trupples/colorimeter-board/README.md

# ARCHIVED, NOT THE LATEST REVISION OF THE M2K COLORIMETER BOARD

This repo contains the first revision of the board. It has since been moved to [analogdevicesinc/education_tools](https://github.com/analogdevicesinc/education_tools).

# Two channel colorimeter

Folders:
- `board-main/` - KiCad project of main PCB
- `board-led/` - KiCad project of RGB LED riser board
- `board-photodiode/` - KiCad project of photodiode riser board
- `symbols/` - common KiCad symbol libraries
- `footprints/` - common KiCad footprint libraries + 3D models

## Main PCB

## Riser boards

Both riser boards position the optical center of their respective devices at 19.05mm above the "bottom" edge of the pin socket connector:

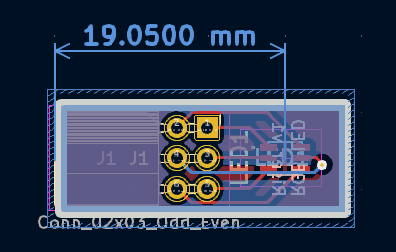
[picture p1: docs/led-riser.png]
LED riser PCB showing 19.05mm dimension


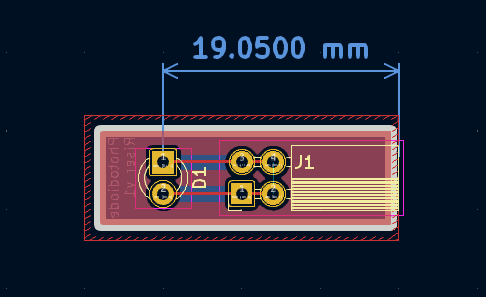
[picture p2: docs/pd-riser.png]
Photodiode riser PCB showing 19.05mm dimension


## TODO

- [ ] Choose one of the many available methods for driving the LEDs
- [ ] Prepare 3D model for 3D printed holder
- [ ] Test manufacturing run!
