trupples/colorimeter-board/footprints/ASMB-UTF0-0D20B.stp

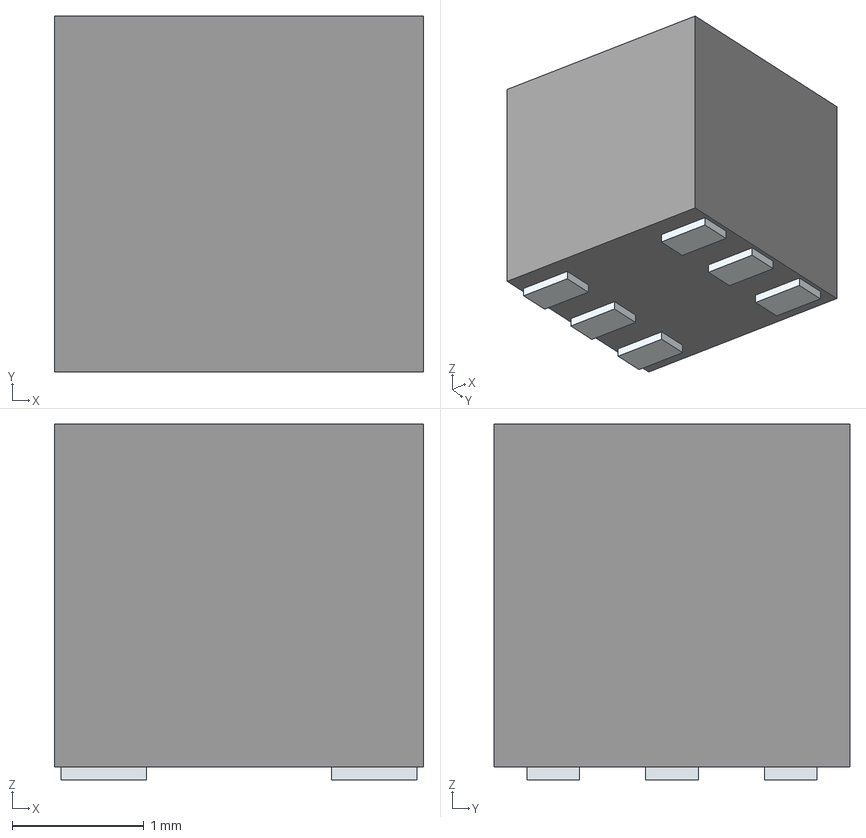
[picture p3: CAD file, 2023-09-25]
footprints/ASMB-UTF0-0D20B.stp
2.80 x 2.70 x 2.70 mm
Pins
