trupples/colorimeter-board/footprints/521-8559F.stp

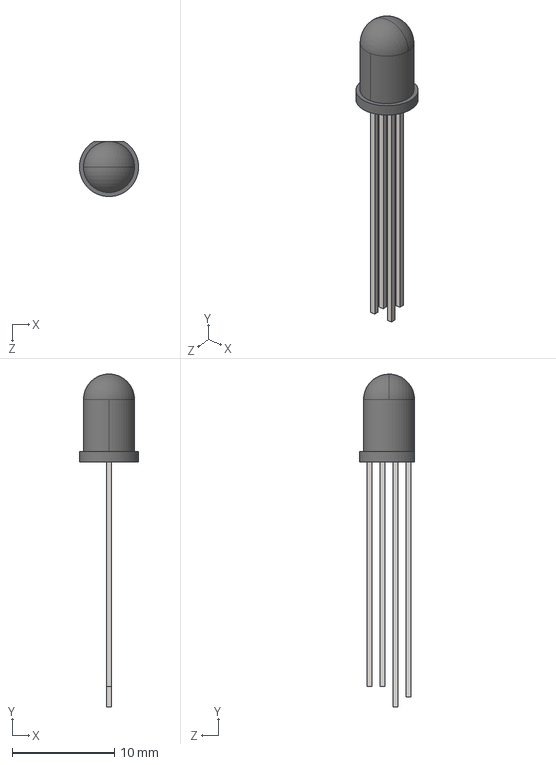
[picture p4: CAD file, 2023-10-06]
footprints/521-8559F.stp
5.79 x 32.6 x 5.40 mm
