trupples/colorimeter-board/footprints/MAX4619CPE+.stp

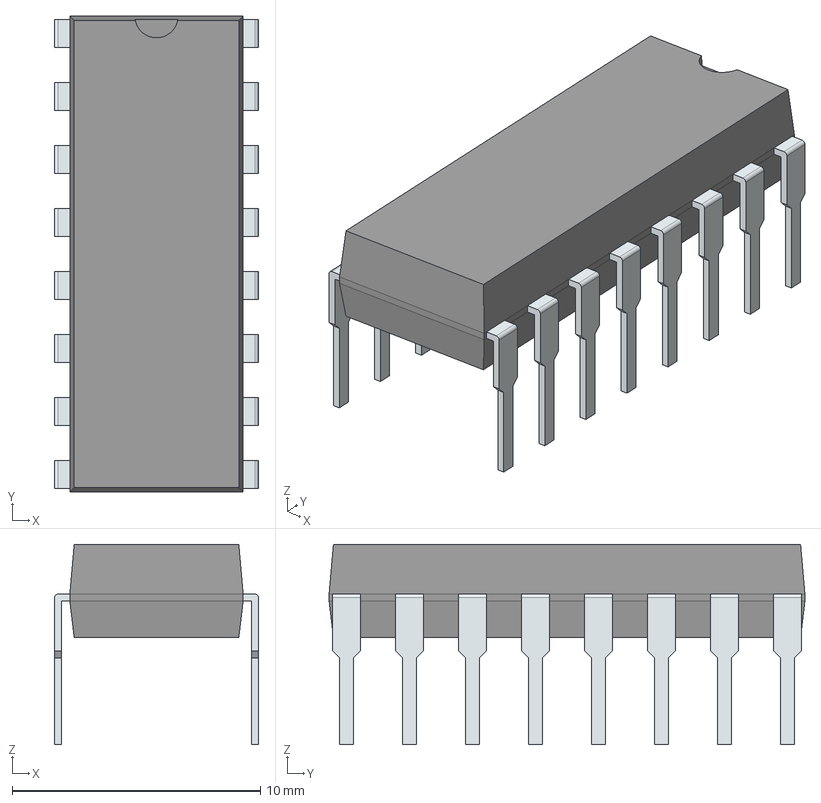
[picture p5: CAD file, 2023-10-06]
footprints/MAX4619CPE+.stp
8.22 x 19.2 x 8.07 mm
PinsArrayLR
