trupples/colorimeter-board/(threads)

Thread 1 (2023-12-19):

Update suggestions

mthoren-adi, 2023-12-19:
Notes from first build / run:

1.  DEFINITELY update the 2x3 LED/PD header footprints with larger holes. Same as the JPx headers would work fine.
2. U1 and U2 - see if you can find a footprint with elongated pads. Also U2 holes are fairly small.
3. All routed traces can be 0.5 mm, with the possible exception of the J1-J2 connections. The wider power traces can stay as-is.
4. Let's take out the 10k TIA resistor option, and add separate compensation capacitors for the 100k and 1M options. The cap should be right in parallel with the resistor such that the jumper selects both.
5. The LED and PD risers are almost perfect and work fine - but they sit off the board by the thickness of the mating header's plastic retainer. The LED/PD doesn't have to be perfectly centered vertically with respect to the beamsplitter, but wouldn't hurt to scoot it down a bit. Also if it touches the main board, then a bead of glue or epoxy could be applied, without gumming up the connector itself if it ever had to be extracted.
6. Add semicircular notches where the m2k box touches the board, to allow full insertion of the connector. It worked fine, but a few extra mm of insertion wouldn't hurt.
