trupples/colorimeter-board/(commit log)

2023-09-22 LED Boost converter half done and awful
    Can barely fit it on the PCB, it's total spaghetti. Saving this to branch out and use the analog switch method
    [colorimeter-2.kicad_pcb, colorimeter-2.kicad_sch]
2023-09-25 MAX4583 switch between LED groups + amp decoupling caps
    [colorimeter-2.kicad_pcb, colorimeter-2.kicad_sch]
2023-09-25 Tweaked decoupling caps and silkscreen
    [colorimeter-2.kicad_pcb]
2023-09-25 [monorepo] Move main board project to its own folder
    [colorimeter-2.kicad_pcb, colorimeter-2.kicad_sch]
2023-09-25 [monorepo] Bring in other board projects
    [ASMB-UTF0-0D20B.stp, colorimeter-led.kicad_pcb, colorimeter-led.kicad_sch, colorimeter-photodiode.kicad_pcb, colorimeter-photodiode.kicad_sch]
2023-09-25 [monorepo] Fix broken symbol and footprints after restructure
    [colorimeter-2.kicad_pcb, colorimeter-2.kicad_sch]
2023-09-25 Clean up local paths
    [colorimeter-2.kicad_pcb, colorimeter-photodiode.kicad_pcb]
2023-09-27 Add SMA connectors, enlarge board to fit them
    [colorimeter-2.kicad_pcb, colorimeter-2.kicad_sch]
2023-10-06 Add jumper for loopback on channel 2
    [colorimeter-2.kicad_pcb, colorimeter-2.kicad_sch]
2023-10-06 Space out SMA connectors and reroute
    [colorimeter-2.kicad_pcb]
2023-10-06 Add LED circuit + rough placement
    [MAX4619CPE+.stp, colorimeter-2.kicad_pcb, colorimeter-2.kicad_sch]
2023-10-06 Changed PD to 3x2 connector + PCB tweaks
    [colorimeter-2.kicad_pcb]
2023-10-06 Add bypass caps
    [colorimeter-2.kicad_pcb, colorimeter-2.kicad_sch]
2023-10-06 Change LED,PD to custom symbol
    [colorimeter-2.kicad_pcb, colorimeter-2.kicad_sch]
2023-10-06 Change PD, LED boards to match pinout on main board
    Added ground connections to both
    Changed Photodiode to have 3x2 connector
    Changed LED to common anode
    Added new symbol & footprint for common anode RGB LED
    [521-8559F.stp, colorimeter-led.kicad_pcb, colorimeter-led.kicad_sch, colorimeter-photodiode.kicad_pcb, colorimeter-photodiode.kicad_sch]
2023-10-06 Tweak main board
    Added teardrops (just me playing around)
    Enlarged it by a bit to not have traces running *right* next to the cut
    [colorimeter-2.kicad_pcb, colorimeter-2.kicad_sch]
2023-10-09 Tie NC pin of switch to V- for pin compatibility
    [colorimeter-2.kicad_pcb, colorimeter-2.kicad_sch]
2023-10-09 Tweak trace widths and schematic layout
    [colorimeter-2.kicad_pcb, colorimeter-2.kicad_sch]
2023-10-09 Start rev 3, many changes
    4 layer PCB, all THT components for easier assembly, slightly larger board
    [colorimeter-2.kicad_pcb, colorimeter-2.kicad_sch]
2023-10-10 Tweak routing
    [colorimeter-2.kicad_pcb]
2023-10-10 Add selection for LED reference/sink
    [colorimeter-2.kicad_pcb, colorimeter-2.kicad_sch]
2023-10-10 Tweak LEDSink routing
    [colorimeter-2.kicad_pcb, colorimeter-2.kicad_sch]
2023-10-10 Space out and tidy up LED power
    [colorimeter-2.kicad_pcb]
2023-10-10 Make power traces THICK (1mm), add net-ties to op-amp +
    [colorimeter-2.kicad_pcb, colorimeter-2.kicad_sch]
2023-10-11 Tweak LED power and decoupling caps
    [colorimeter-2.kicad_pcb, colorimeter-2.kicad_sch]
2023-10-11 Remove "Helloworld Devices", add "FiSl"
    [colorimeter-2.kicad_pcb]
2023-10-12 Fix bad switch connection
    Bsw and B1 were not connected to the correct pins of the switch IC
    [colorimeter-2.kicad_pcb, colorimeter-2.kicad_sch]
2023-10-12 Mark unused / general purpose pins
    [colorimeter-2.kicad_sch]
2023-10-12 Add comments and tidy up schematic
    [colorimeter-2.kicad_sch]
2023-10-12 Add m2k header pinout silkscreen
    [colorimeter-2.kicad_pcb]
2023-10-12 Reorder photodiode riser board pins
    [colorimeter-2.kicad_pcb, colorimeter-photodiode.kicad_pcb, colorimeter-photodiode.kicad_sch]
2023-10-12 Change net ties to 0ohm resistor/solder jumper
    [colorimeter-2.kicad_pcb, colorimeter-2.kicad_sch]
2023-10-12 Set some TIA gains (10k, 100k, 1M)
    [colorimeter-2.kicad_pcb, colorimeter-2.kicad_sch]
2023-10-13 Tweak silkscreen
    Move passive designators out from under the components. Move SMA designators to top layer
    [colorimeter-2.kicad_pcb, colorimeter-2.kicad_sch]
2023-10-13 Make solder jumpers actually solder jumpers
    [colorimeter-2.kicad_pcb, colorimeter-2.kicad_sch]
2023-10-13 Widen board edge at m2k and SMA connectors
    [colorimeter-2.kicad_pcb]
2023-10-13 Move switch IC to middle of board
    [colorimeter-2.kicad_pcb, colorimeter-2.kicad_sch]
2023-10-13 Move vias so they dont overlap silkscreen
    [colorimeter-2.kicad_pcb]
2023-10-13 Generate riser board gerbers
    [colorimeter-led-B_Cu.gbl, colorimeter-led-B_Mask.gbs, colorimeter-led-B_Paste.gbp, colorimeter-led-B_Silkscreen.gbo, colorimeter-led-Edge_Cuts.gm1, colorimeter-led-F_Cu.gtl, colorimeter-led-F_Mask.gts, colorimeter-led-F_Paste.gtp]
2023-10-13 Add thermal reliefs for ground plane
    [colorimeter-2.kicad_pcb]
2023-10-13 Generate pre-feedback gerbers of main board
    [colorimeter-2-B_Cu.gbl, colorimeter-2-B_Mask.gbs, colorimeter-2-B_Paste.gbp, colorimeter-2-B_Silkscreen.gbo, colorimeter-2-Edge_Cuts.gm1, colorimeter-2-F_Cu.gtl, colorimeter-2-F_Mask.gts, colorimeter-2-F_Paste.gtp]
2023-10-13 Add Dr Blue
    [colorimeter-2.kicad_pcb]
2023-10-13 Regenerate gerbers with Prof Blue
    [colorimeter-2-B_Cu.gbl, colorimeter-2-B_Mask.gbs, colorimeter-2-B_Paste.gbp, colorimeter-2-B_Silkscreen.gbo, colorimeter-2-Edge_Cuts.gm1, colorimeter-2-F_Cu.gtl, colorimeter-2-F_Mask.gts, colorimeter-2-F_Paste.gtp]
